cnlohr/cnpihats/rpi_with_supply/rpi_with_supply.kicad_pcb

## KiCad design rpi_with_supply/rpi_with_supply.kicad_pcb (2018-10-24)

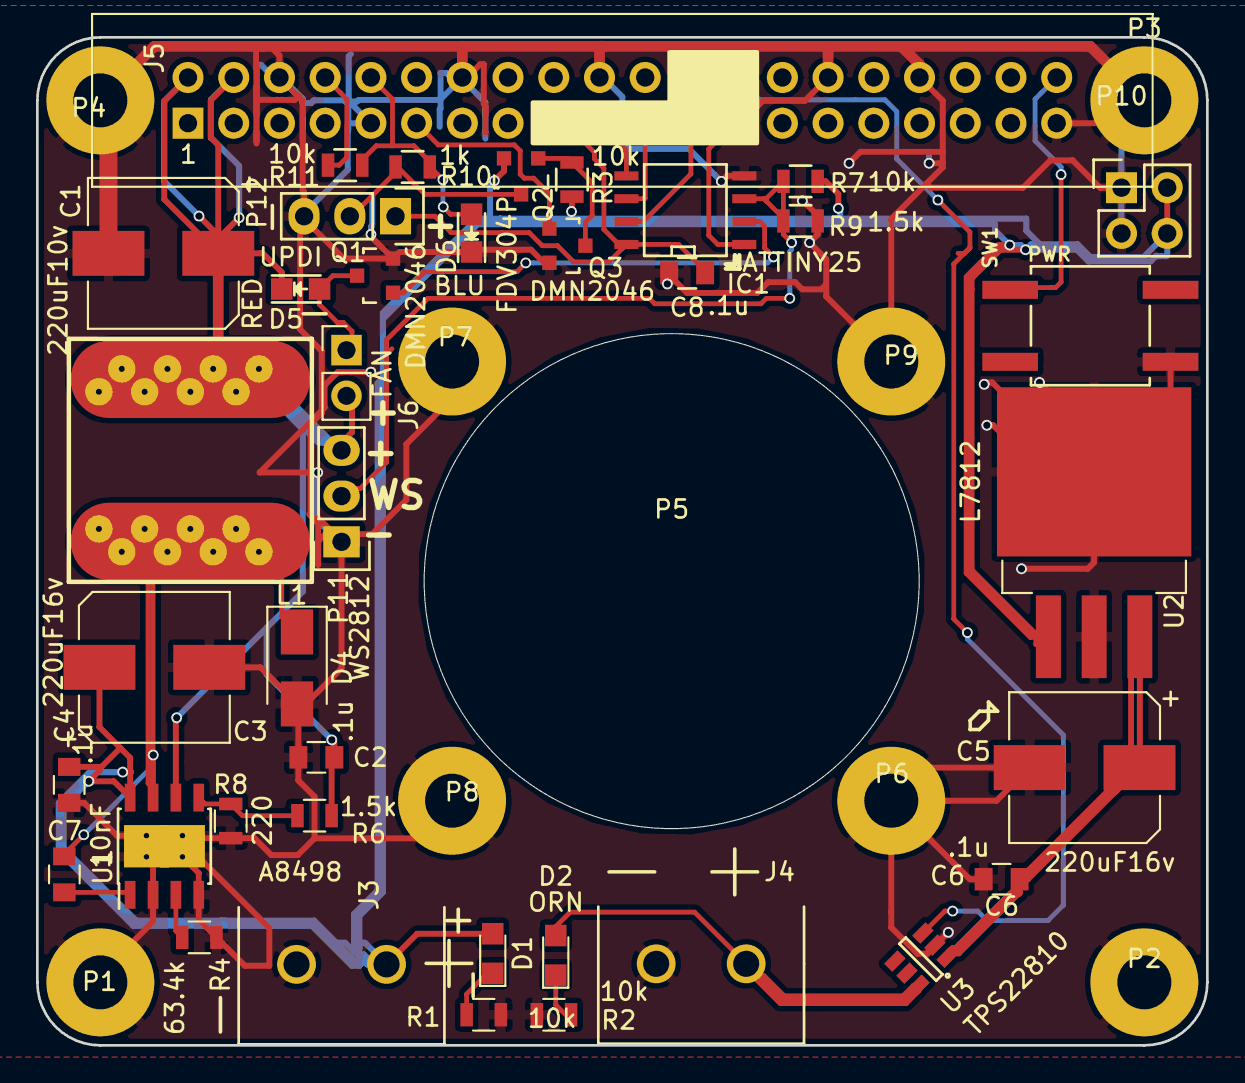
[picture p1: board rpi_with_supply.kicad_pcb from above]

Board: 2 copper layers, 65.0 x 56.0 mm, 48 parts (0 on the bottom side), 26 nets.

Parts:
C1: 220uF10v; CP_Elec_8x6.7
C2, C4, C6, C8: .1u; C_0805
C3, C5: 220uF16v; CP_Elec_8x6.7
C7: 10nF; C_0805
D1, D5: RED; LED_0805
D2: ORN; LED_0805
D4: D_Schottky; D_SMA
D6: BLU; LED_0805
IC1: ATTINY25; SOIC-8-WIDE
J3, J4: Phoenix 1933189 COMBICON; PHOENIX1933189
J5: Raspberry_Pi_2_3; IDC_Header_Straight_40pins
J6: FAN; Socket_Strip_Straight_1x02_Pitch2.54mm
L1: 68uH; CHARLES_INDUCTOR
P1, P2, P3, P4, P5, P6, P7, P8, P9: CONN_1; MountingHole_3mm_Pad
P10: CONN_02X02; Pin_Header_Straight_2x02
P11: WS2812; Pin_Header_Straight_1x03
P12: UPDI; Pin_Header_Straight_1x03
Q1, Q3: DMN2046; SOT-23
Q2: FDV304P; SOT-23
R1, R2, R3, R7, R11: 10k; R_0805
R4: 63.4k; R_0805
R6, R9: 1.5k; R_0805
R8: 220; R_0805
R10: 1k; R_0805
SW1: PWR; TACTILE10
U1: A8498; SOIC-8-EP-THRU
U2: L7812; TO-263-3Lead
U3: TPS22810; SOT-23-6

Connections:
+3V3: C8.1, IC1.8, J5.17, P12.1
+12V: C5.1, C6.1, U2.3, U3.1
FANCTL: IC1.2, Q1.1
GND: C1.2, C2.2, C3.2, C4.2, C5.2, C6.2, C8.2, D4.2, D6.1, IC1.4, J3.1, J4.1, J5.6, J5.9, J5.14, J5.20, J5.25, J5.30, J5.34, J5.39, P1.1, P2.1, P3.1, P4.1, P6.1, P7.1, P8.1, P9.1, P10.1, P10.3, P11.1, P12.3, Q1.2, Q3.2, R1.1, R2.1, R4.2, R8.1, R9.2, SW1.1, U1.2, U1.4, U1.9, U2.2, U3.2
GPIO17: J5.11, Q3.1
GPIO21: J5.40, SW1.4
HT: C3.1, C4.1, D1.2, J3.2, P10.2, P10.4, Q2.2, R3.2, R7.1, U1.8, U2.1
INPUT: J5.26, U3.3
MISO: IC1.6, J5.21
MOSI: IC1.5, J5.19
unnamed: C7.1, D4.1, L1.1, U1.7
unnamed: C7.2, U1.1
unnamed: D1.1, R1.2
unnamed: D2.1, R2.2
unnamed: D5.2, J6.1, Q1.3
unnamed: IC1.3, P11.2, R7.2, R9.1
unnamed: J5.8, R11.1
unnamed: P12.2, Q2.3, R10.2
unnamed: Q2.1, Q3.3, R3.1
unnamed: R4.1, U1.3
unnamed: R6.1, R8.2, U1.5
OUT: D2.2, J4.2, U3.6
PI_PWR: C1.1, C2.1, D5.1, J5.2, J5.4, J6.2, L1.2, P11.3, R6.2, U1.6
SCK: IC1.7, J5.23
TXRX: D6.2, J5.10, R10.1, R11.2
~AVRRST~: IC1.1, J5.24
