cnlohr/cnpihats/rpi_esp_flasher/rpi_esp_flasher.kicad_pcb

## KiCad design rpi_esp_flasher/rpi_esp_flasher.kicad_pcb (2018-10-24)

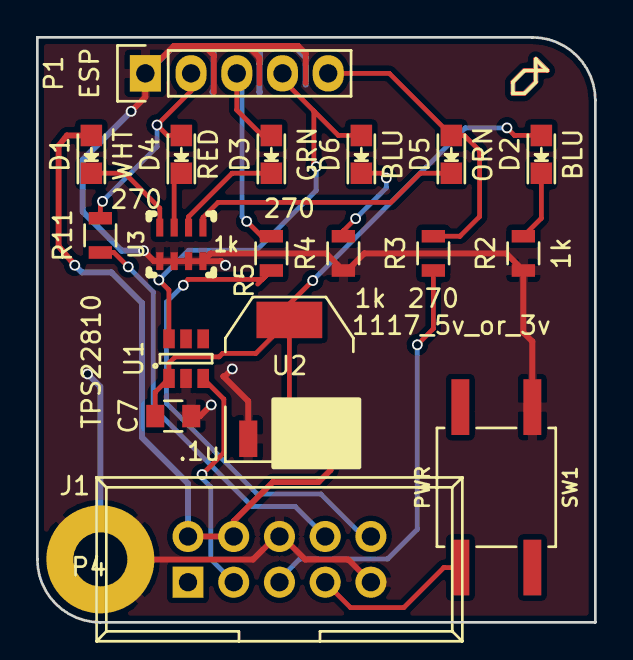
[picture p2: board rpi_esp_flasher.kicad_pcb from above]

Board: 2 copper layers, 31.0 x 32.5 mm, 19 parts (0 on the bottom side), 18 nets.

Parts:
C7: .1u; C_0805
D1: WHT; LED_0805
D2, D6: BLU; LED_0805
D3: GRN; LED_0805
D4: RED; LED_0805
D5: ORN; LED_0805
J1: Raspberry_Pi_2_3; IDC_Header_Straight_10pins
P1: ESP; Pin_Header_Straight_1x05
P4: CONN_1; MountingHole_3mm_Pad
R2, R4: 1k; R_0805
R3, R5, R11: 270; R_0805
SW1: PWR; TACTILE10
U1: TPS22810; SOT-23-6
U2: 1117_5v_or_3v; SOT-223
U3: 1k; NETWORK1206

Connections:
GND: C7.1, J1.6, J1.9, P1.1, P4.1, R2.1, R4.1, SW1.1, U1.2, U2.1, U3.5, U3.6, U3.7, U3.8
GPIO2: J1.3, U1.3
GPIO3: D5.2, P1.5, R3.2
GPIO4: J1.7, SW1.4
LRX: D3.2, P1.3, R5.2
LTX: D4.2, P1.2, R11.2
unnamed: C7.2, D2.2, U1.1, U2.2, U2.4
unnamed: D1.1, U3.4
unnamed: D2.1, R2.2
unnamed: D3.1, U3.2
unnamed: D4.1, U3.3
unnamed: D5.1, U3.1
unnamed: D6.1, R4.2
unnamed: D6.2, P1.4, U1.6
unnamed: J1.5, R3.1
unnamed: J1.8, R11.1
unnamed: J1.10, R5.1
PI_PWR: D1.2, J1.2, J1.4, U2.3
