cnlohr/cnpihats/orangpione_with_supply/orangepione_with_supply.kicad_pcb

## KiCad design orangpione_with_supply/orangepione_with_supply.kicad_pcb (2018-04-12)

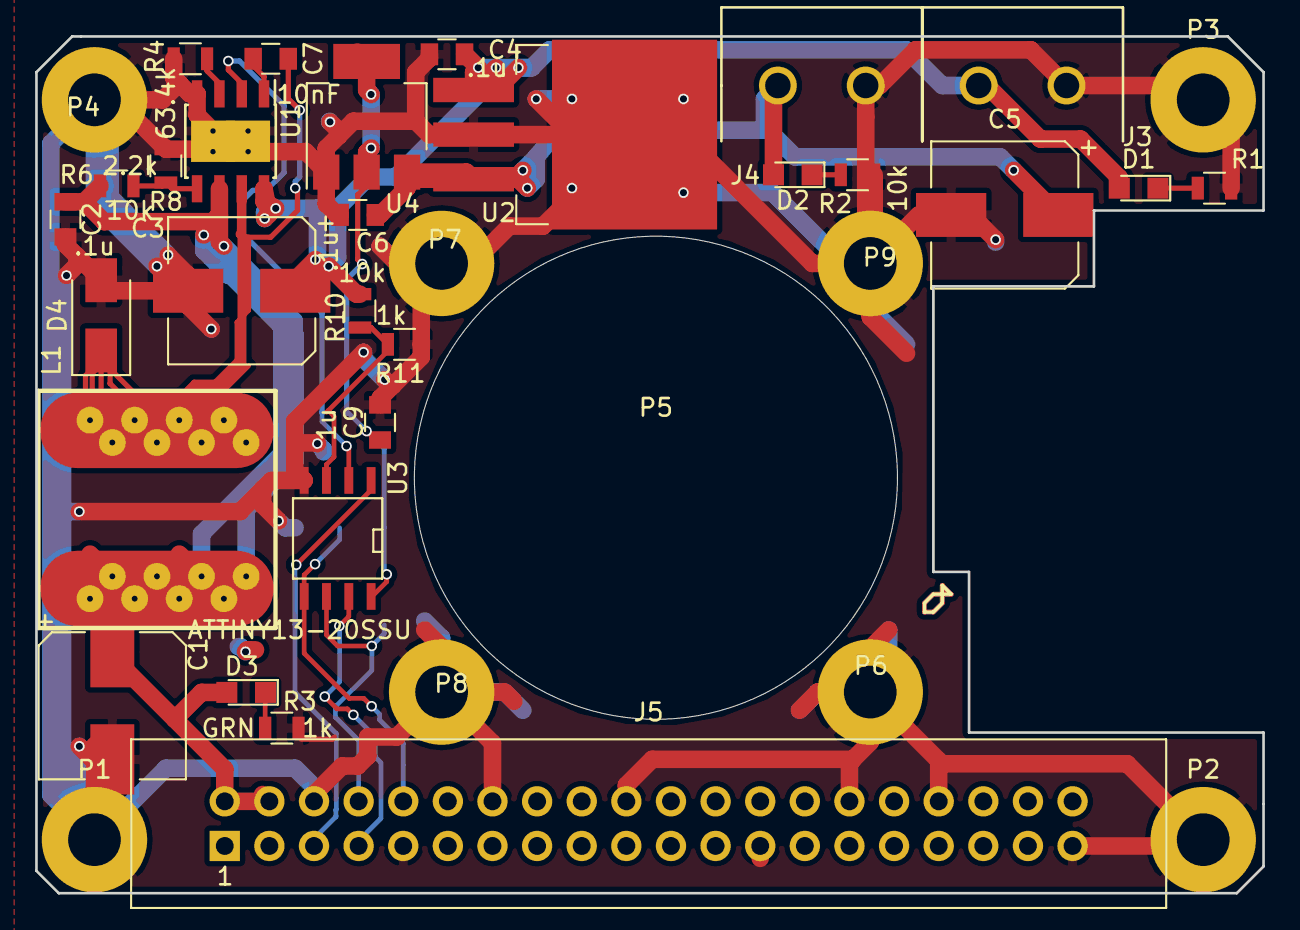
[picture p3: board orangepione_with_supply.kicad_pcb from above]

Board: 2 copper layers, 69.9 x 48.8 mm, 38 parts (1 on the bottom side), 18 nets.

Parts:
C1, C3, C5: 220uF; CP_Elec_8x6.7
C2, C4, C6: .1u; C_0805
C7: 10nF; C_0805
C9: 1u; C_0805
D1: RED; LED_0805
D2: ORN; LED_0805
D3: GRN; LED_0805
D4: D_Schottky; D_SMA
J3, J4: Phoenix 1933189 COMBICON; PHOENIX1933189
J5: Raspberry_Pi_2_3; IDC_Header_Straight_40pins
J7: AVRISP6; RIBBON6SMT
L1: 68uH; CHARLES_INDUCTOR
P1, P2, P3, P4, P5, P6, P7, P8, P9: CONN_1; MountingHole_3mm_Pad
R1, R2, R6, R10: 10k; R_0805
R3, R11: 1k; R_0805
R4: 63.4k; R_0805
R8: 2.2k; R_0805
U1: A8498; SOIC-8-EP-THRU
U2: L7812; TO-263-3Lead
U3: ATTINY13-20SSU; SO8WIDE
U4: AP1117; SOT-223

Connections:
+5V: C9.1, J7.2, U3.8, U4.2, U4.4
+12V: C5.1, C6.1, D2.2, J4.2, U2.3, U4.3
GND: C1.2, C2.2, C3.2, C4.2, C5.2, C6.2, C9.2, D4.2, J3.1, J4.1, J5.6, J5.9, J5.14, J5.20, J5.25, J5.30, J5.34, J5.39, J7.6, P1.1, P2.1, P3.1, P4.1, P6.1, P7.1, P8.1, P9.1, R1.1, R2.1, R3.2, R4.2, R8.1, R11.2, U1.4, U1.9, U2.2, U3.4, U4.1
HT: C3.1, C4.1, D1.2, J3.2, R10.1, U1.8, U2.1
MISO: J5.8, J7.1, U3.6
MOSI: J5.10, J7.4, U3.5
unnamed: C7.1, D4.1, L1.1, U1.7
unnamed: C7.2, U1.1
unnamed: D1.1, R1.2
unnamed: D2.1, R2.2
unnamed: D3.1, R3.1
unnamed: R4.1, U1.3
unnamed: R6.1, R8.2, U1.5
unnamed: R10.2, R11.1, U3.3
PI_PWR: C1.1, C2.1, D3.2, J5.2, J5.4, L1.2, R6.2, U1.6
PWR_ENB: U1.2, U3.2
RST: J5.5, J7.5, U3.1
SCK: J5.7, J7.3, U3.7
