cnlohr/cnpihats/(commit log)

2018-04-12 add newest hat.
    [orangepione_with_supply-B.Cu.gbl, orangepione_with_supply-B.Mask.gbs, orangepione_with_supply-B.SilkS.gbo, orangepione_with_supply-Edge.Cuts.gm1, orangepione_with_supply-F.Cu.gtl, orangepione_with_supply-F.Mask.gts, orangepione_with_supply-F.Paste.gtp, orangepione_with_supply-F.SilkS.gto]
2018-06-22 Bump rpi
    [rpi_with_supply-B.Cu.gbl, rpi_with_supply-B.Mask.gbs, rpi_with_supply-B.SilkS.gbo, rpi_with_supply-Edge.Cuts.gm1, rpi_with_supply-F.Cu.gtl, rpi_with_supply-F.Mask.gts, rpi_with_supply-F.Paste.gtp, rpi_with_supply-F.SilkS.gto]
2018-08-07 bump to rev A
    [rpi_with_supply-B.Cu.gbl, rpi_with_supply-B.Mask.gbs, rpi_with_supply-B.SilkS.gbo, rpi_with_supply-Edge.Cuts.gm1, rpi_with_supply-F.Cu.gtl, rpi_with_supply-F.Mask.gts, rpi_with_supply-F.Paste.gtp, rpi_with_supply-F.SilkS.gto]
2018-08-07 update shcematic
    [rpi_with_supply.sch]
2018-08-19 bump to rev b
    [rpi_with_supply.kicad_pcb, rpi_with_supply.sch]
2018-08-19 Bump design with pull up
    [rpi_with_supply.kicad_pcb, rpi_with_supply.sch]
2018-08-27 update design
    [rpi_with_supply.kicad_pcb, rpi_with_supply.sch]
2018-10-24 Bump operations! Now can calibrate ATTiny13's.
2018-10-24 Bump - fix flashing tool to add more useful features
    [avr_softspi.c, avr_softspi.h, avrflasher.c]
2018-10-25 work further on system, allowing calibration of ATTiny25's
2018-10-25 bump design
    [rpi_with_supply.kicad_pcb, rpi_with_supply.sch]
2018-10-31 add exp flasher
    [rpi_esp_flasher.kicad_pcb, rpi_esp_flasher.sch]
2018-11-02 switch to LM5110
    [rpi_esp_flasher.kicad_pcb, rpi_esp_flasher.sch]
2018-11-02 update design with new switch
    [rpi_with_supply.kicad_pcb, rpi_with_supply.sch]
2018-11-02 Update revb with new switch
    [rpi_esp_flasher.kicad_pcb, rpi_esp_flasher.sch]
